andreangelucci/rubik-bot/apresentacao/banca/resource/superior.jpg

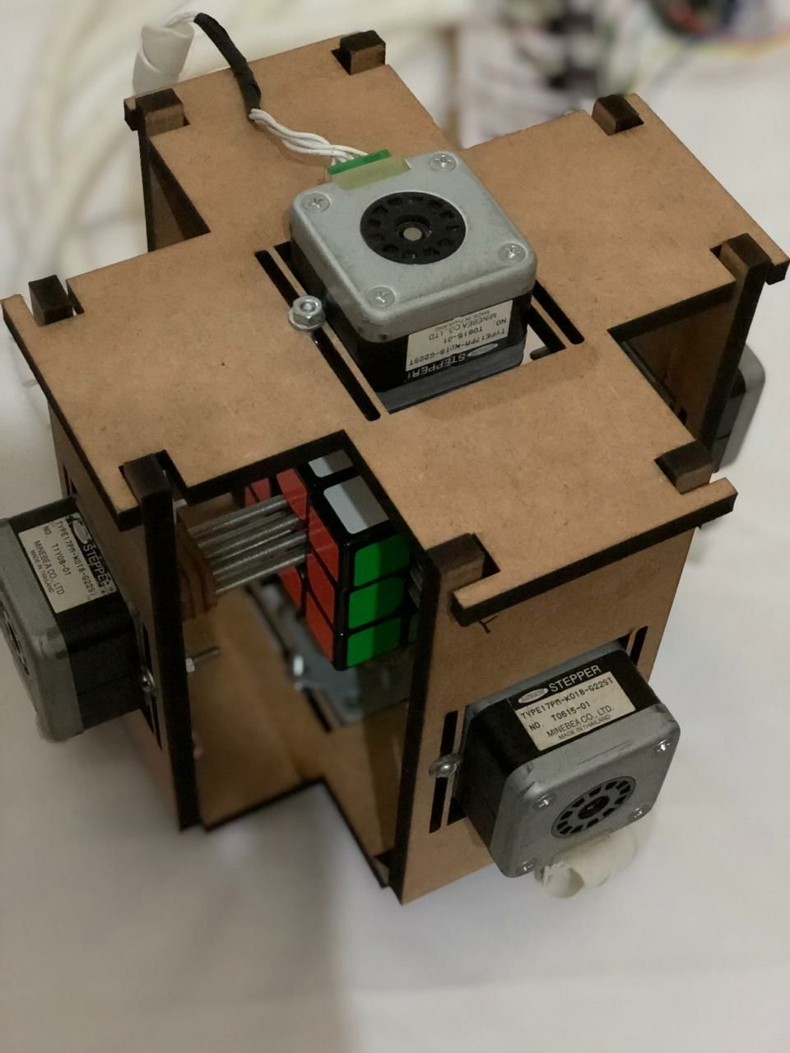
apresentacao/banca/resource/superior.jpg
