andreangelucci/rubik-bot/apresentacao/banca/resource/educacao.jpg

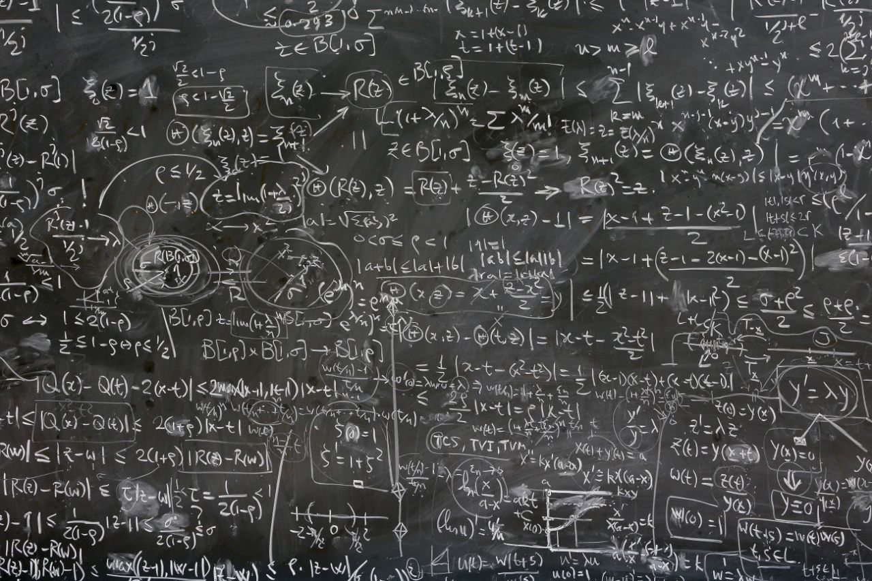
apresentacao/banca/resource/educacao.jpg
