andreangelucci/rubik-bot/README.md

# rubik-bot

Sistema de solução do Cubo de Rubik.

Demonstração:

demo
