andreangelucci/rubik-bot/apresentacao/banca/resource/cubo.gif

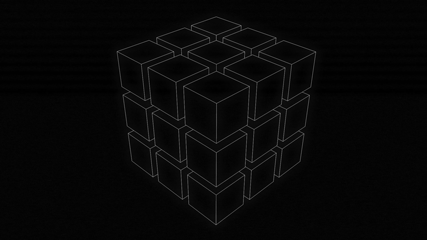
apresentacao/banca/resource/cubo.gif
