andreangelucci/rubik-bot/apresentacao/banca/resource/cubo.jpeg

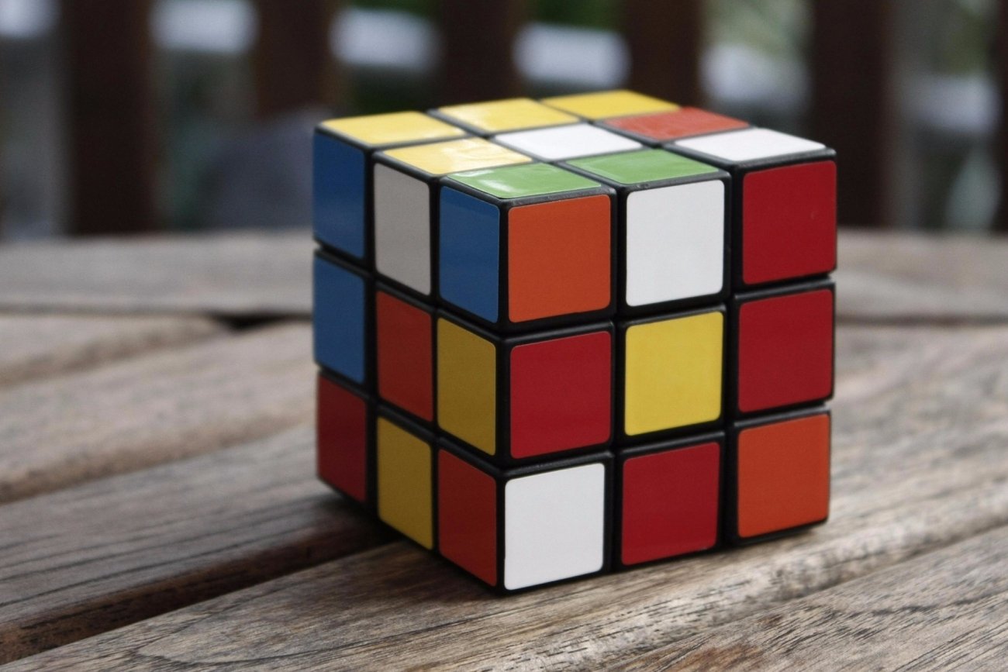
apresentacao/banca/resource/cubo.jpeg
