andreangelucci/rubik-bot/apresentacao/banca/resource/erno.jpeg

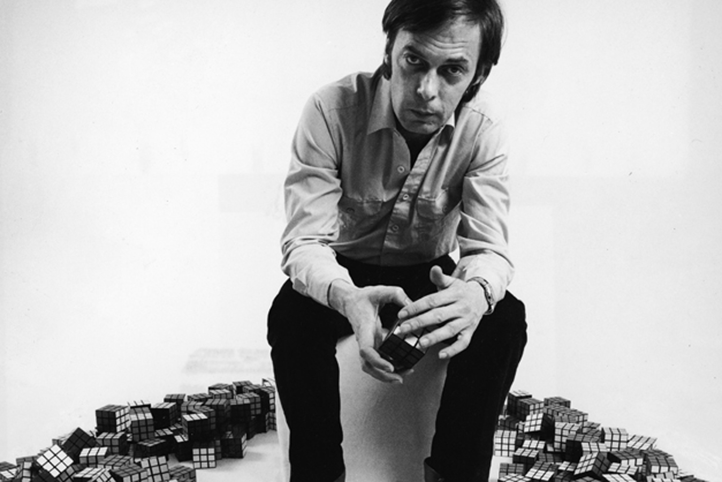
apresentacao/banca/resource/erno.jpeg
