andreangelucci/rubik-bot/apresentacao/banca/resource/frente2.jpg

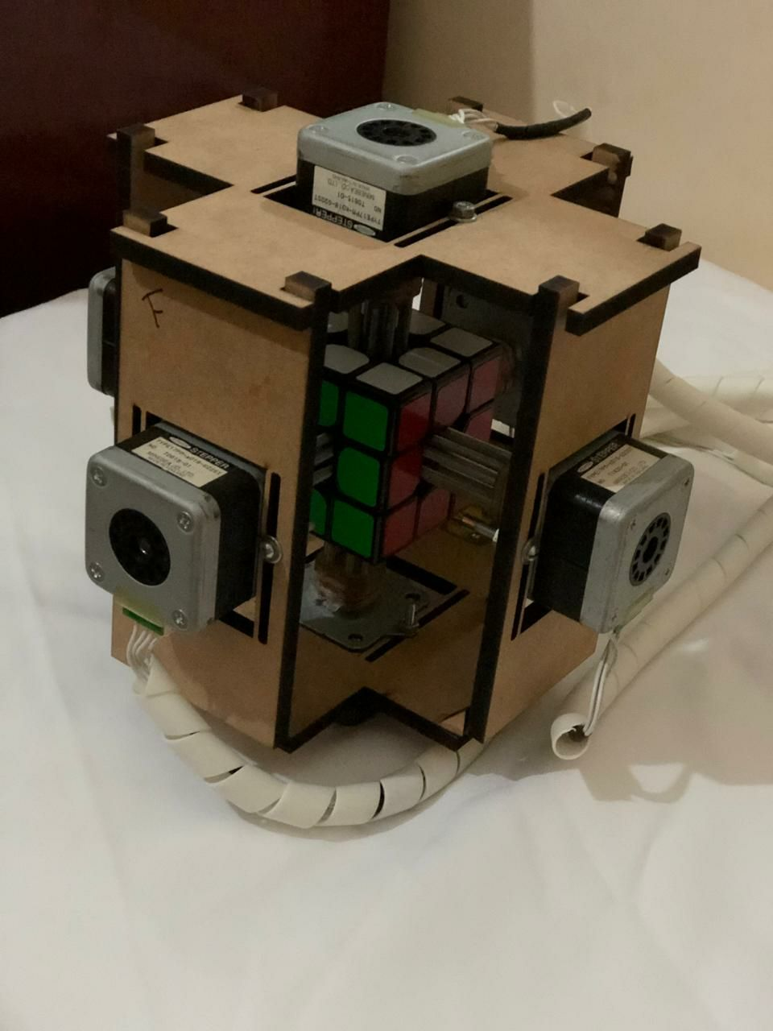
apresentacao/banca/resource/frente2.jpg
