andreangelucci/rubik-bot/apresentacao/banca/resource/frente.png

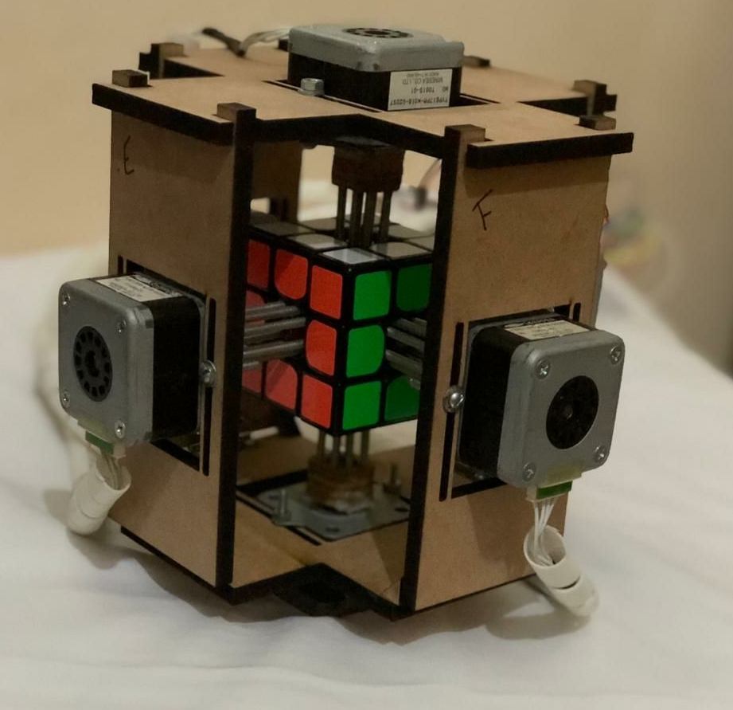
apresentacao/banca/resource/frente.png
