andreangelucci/rubik-bot/apresentacao/banca/resource/interior.jpg

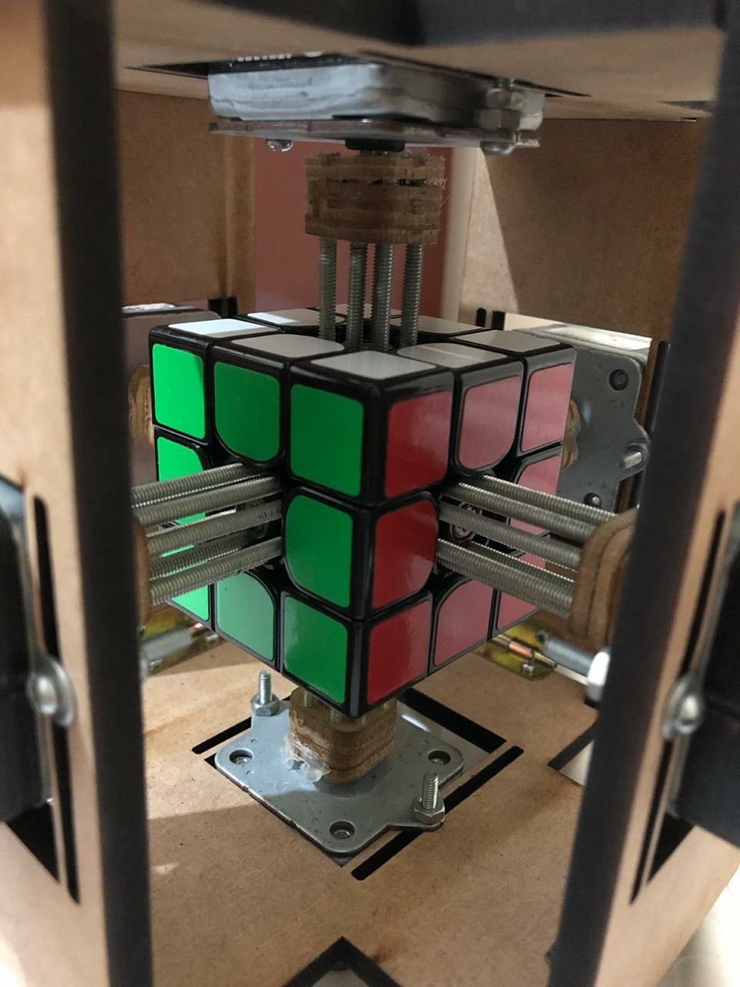
apresentacao/banca/resource/interior.jpg
