andreangelucci/rubik-bot/cortes-mdf/suporte.jpeg

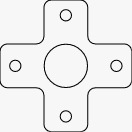
cortes-mdf/suporte.jpeg
