andreangelucci/rubik-bot/placa/placa.png

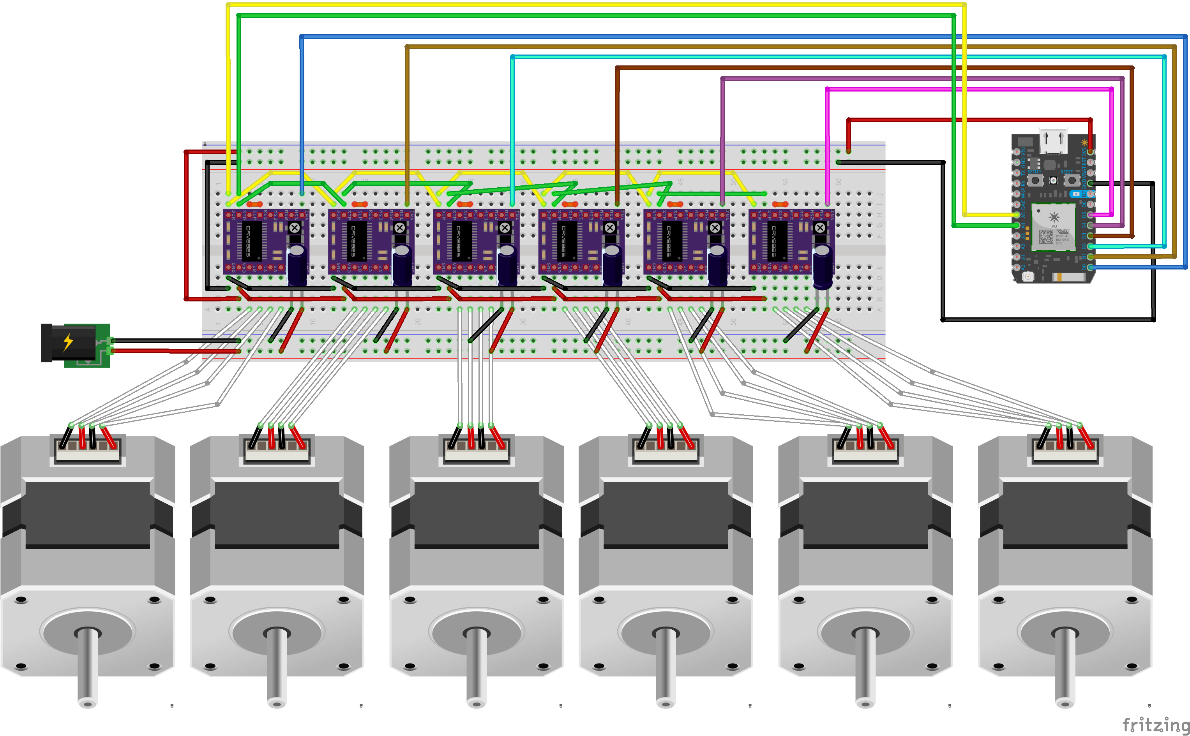
placa/placa.png
