andreangelucci/rubik-bot/cortes-mdf/suporte motor.dxf

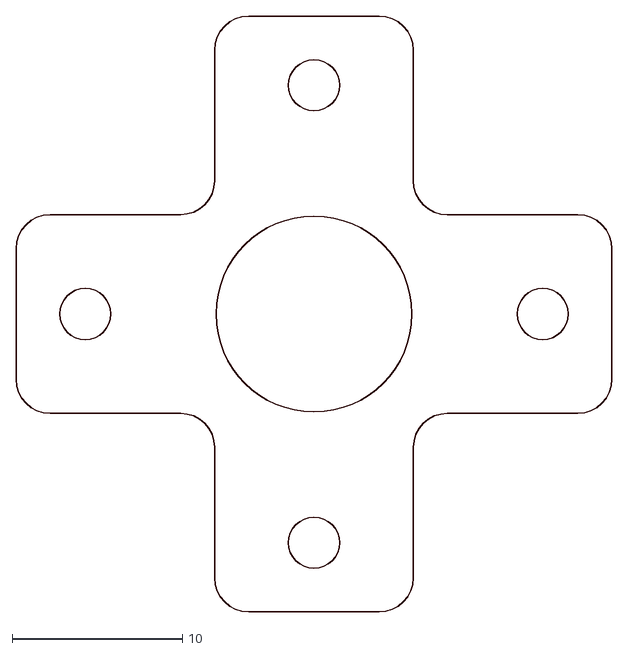
[picture p32: CAD file, 2018-10-03]
cortes-mdf/suporte motor.dxf
35.0 x 35.0
