andreangelucci/rubik-bot/cortes-mdf/base.dxf

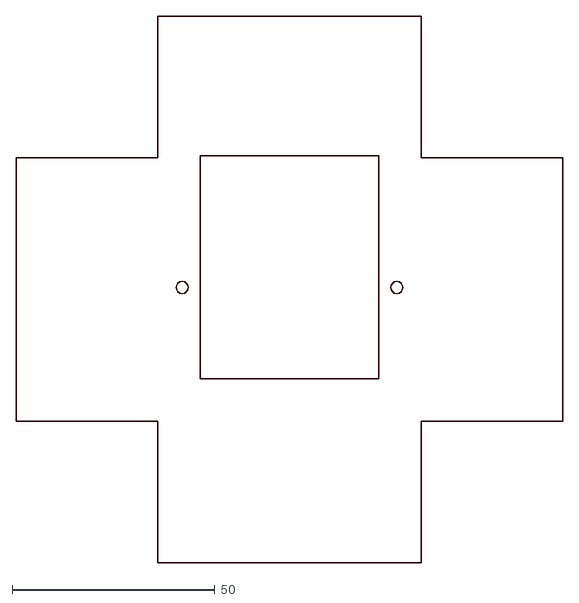
[picture p33: CAD file, 2018-10-03]
cortes-mdf/base.dxf
135.0 x 135.0
