andreangelucci/rubik-bot/cortes-mdf/teto.dxf

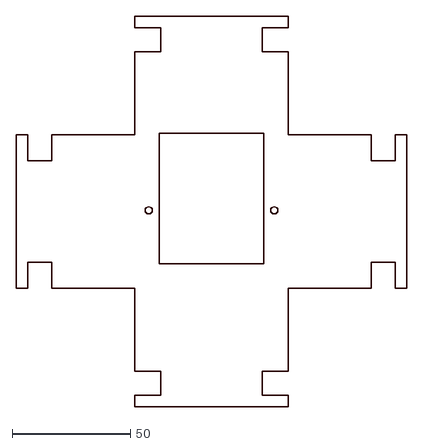
[picture p34: CAD file, 2018-10-03]
cortes-mdf/teto.dxf
165.0 x 165.0
