andreangelucci/rubik-bot/cortes-mdf/laterais.dxf

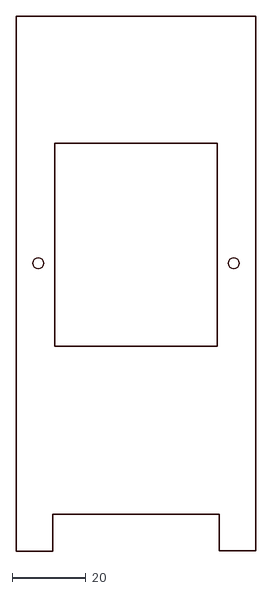
[picture p35: CAD file, 2018-10-03]
cortes-mdf/laterais.dxf
65.0 x 145.0
