andreangelucci/rubik-bot/(list of files, drawings)

Other design files:
placa/Untitled Sketch 3.fzz
