andreangelucci/rubik-bot/rubik-bot/rubik-bot/src/Motor/Motor.h

#ifndef Motor_h
#define Motor_h

enum MotorFace {frente, direita, costas, esquerda, cima, baixo};
enum Sentido {horario, antihorario};

class Motor
{
  public:
    Motor(int pinEnabled);    
    void girar(Sentido s, int voltas);
  private:
    int _pinEnabled;
    bool _habilitado;
    void _setHabilitado(bool value);
    void _definirSentido(Sentido s);
};

#endif
