andreangelucci/rubik-bot/(commit log)

2018-09-26 big bang!
    [Untitled Sketch 3.fzz]
2018-10-03 ajustes no firmware e vetores para corte do equipamento
    [base.dxf, laterais.dxf, suporte motor.dxf, teto.dxf]
2018-10-04 processo de amostragem das pecas do cubo
    atraves da captura da imagem da webcam
2018-10-09 finalizado processo de zipar e reconhecer as cores
2018-10-10 processo de representacao do cubo apos capturar e analisar as imagens
    [em andamento]
2018-10-11 refatoracoes e finalizado processo de representacao das cores capturadas no cubo
2018-10-18 execucao do algoritmo de solucao Kociemba
2018-10-22 controle dos 6 motores no rubik bot
2018-10-22 adicionadas variaveis de ambiente ao projeto com dotenv
2018-10-25 finalizado metodo de escolha da nova cor
2018-10-25 ajuda e arquivos de resource
2018-10-26 preparacao para receber a string de solucao e passar o regex para encontrar os movimentos
2018-10-26 encontrando a string de definicao do cubo e enviado para o algoritmo de kociemba
    ~finalizado~
2018-11-06 subcapitulo com informacoes sobre motores de passo
2018-11-06 processo de contingencia da analise da peca com watson
    usa o script em python
2018-11-07 melhorias na monografia e add representacao do circuito do rubik bot
    [Untitled Sketch 3.fzz]
2018-11-13 ajustes na rotacao dos motores
2018-11-22 ajustes finais para a rotacao
    motor inferior tambem estava com o sentido invertido; inserido um timer apos enviar a msg serial para que de tempo do robo montar
2018-11-22 gif de demonstracao
2018-11-27 fonte de contingencia: Ubuntu mono
2018-11-28 atualizalicao do gif de demonstracao
2018-11-29 alteracoes finais da monografia
    falta a remocao da numeracao de algumas paginas
2018-12-05 preparacao para apresentacao banca
2018-12-17 aumento na velocidade de rotacao
2018-12-21 remocao de gif errado
